kostyaz/sun3-kbd-digispark/(commit log)

2019-11-08 Add Arduino sketch
2019-11-09 Remove keyboard reset (does not seem to work on type 3)
    [sun3.ino]
2019-11-09 Try to improve stability of USB comm by triggering update more often; do not send the same keys twice
    [sun3.ino]
